Distr0hopper/Self-Driving-RC-Car/README.md

# Self-Driving-RC-Car
A RC-Car that automatically can drive down a building and detect where a misplaced barrel is, report its position, dock a magnet to it and return with it, pulling it to start in exactly one minute.

## Project Structure

- `/safety-system` - ESP32 wireless safety switch (Huzzah remote + Dev C onboard)
- `/motor-control` - ESP32 motor controller code (PlatformIO project)
- `/ros2` - ROS2 packages (will be added) 
- `/docs` - Documentation (will be added)
