Distr0hopper/Self-Driving-RC-Car/docs/hardware/motor_specs.md

# Motor Specifications

## Katana (200 RPM)
- Model: gs20205-03 25GA371
- Speed: 200 RPM @ 12V
- Encoder: 11 PPR
- Counts/Rev: 988.3
- Gear Ratio: 22.46:1 (~22.5:1)
- Wiring: A→Yellow, B→Green

### Calibration Test (1000 revolutions)
- Range: 987.82 to 988.67 counts/rev
- Average: 988.3 counts/rev

## Kimono (1000 RPM)
- Model: SKU gs20179-01 JGA25-371 DDC12V1000RPM
- Speed: 1000 RPM @ 12V
- Encoder: 11 PPR
- Counts/Rev: 204.24
- Gear Ratio: 4.64
- Wiring: A→Yellow, B→Green

### Calibration Test (1000 revolutions)
- Range: 204.09 to 204.24 counts/rev
- Average: 204.19 counts/rev

## Not-Used // Backup (100 RPM)
- Model: gs20205-05 25GA371
- Speed: 100 RPM @ 12V
- Encoder: 11 PPR
- Counts/Rev: 2174.92
- Gear Ratio: 49.43:1 (~49.5:1)
- Wiring: A→Yellow, B→Green

### Calibration Test (1000 revolutions)
- Range: 2173.02 to 2175.16 counts/rev
- Average: 2174.92 counts/rev
