Distr0hopper/Self-Driving-RC-Car/docs/schematics/katana_schematics.png

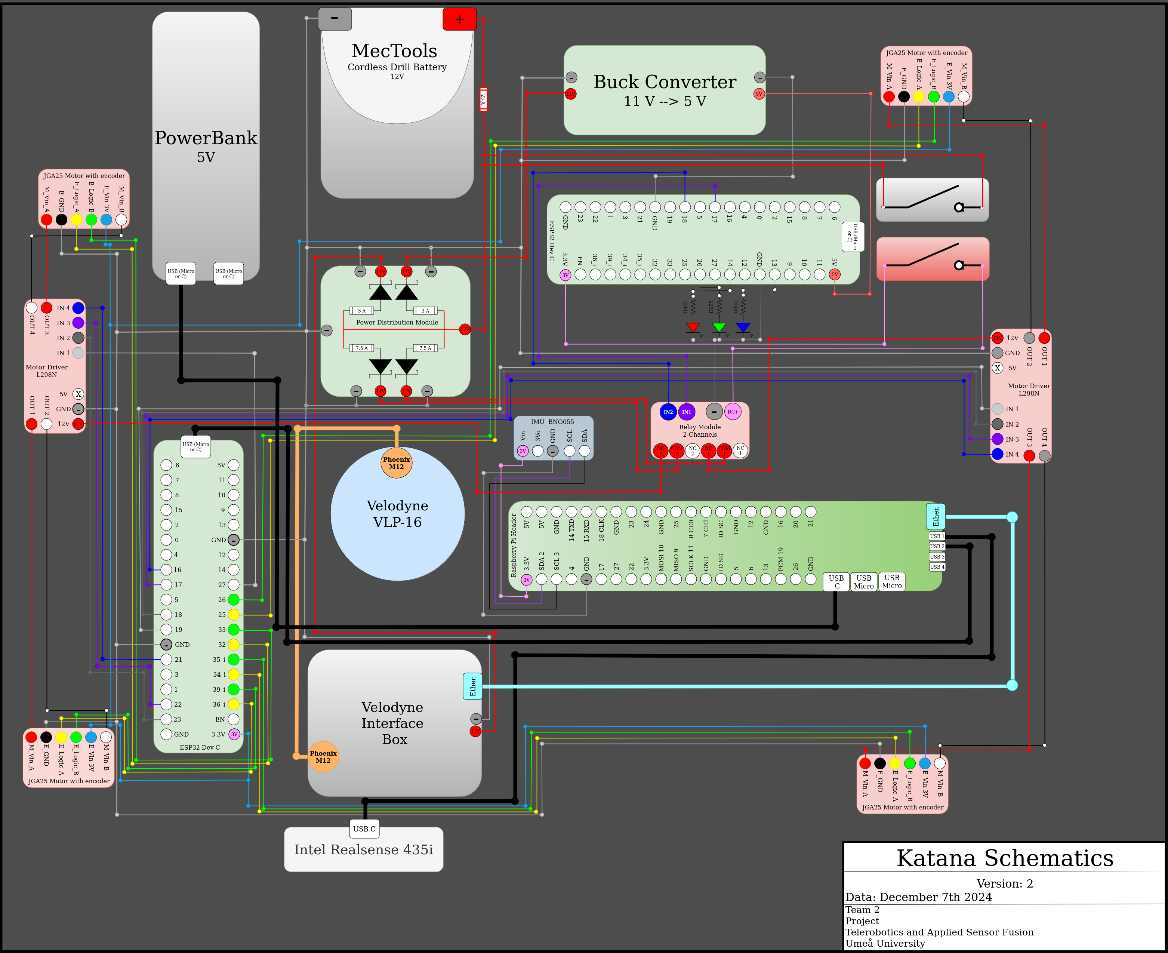
docs/schematics/katana_schematics.png
