Distr0hopper/Self-Driving-RC-Car/MotorControlCalibration/step_response_results/jga25_371_12v0_20241208_044220.csv

PWM | Velocity (m/s) | Speed (RPS) | Speed (RPM)
255 | 4.845462390880768 | 6.321141730119245 | 379.2685038071547
