Distr0hopper/Self-Driving-RC-Car/MotorControlCalibration/step_response_results/jga25_371_12v0_20241208_044220.png

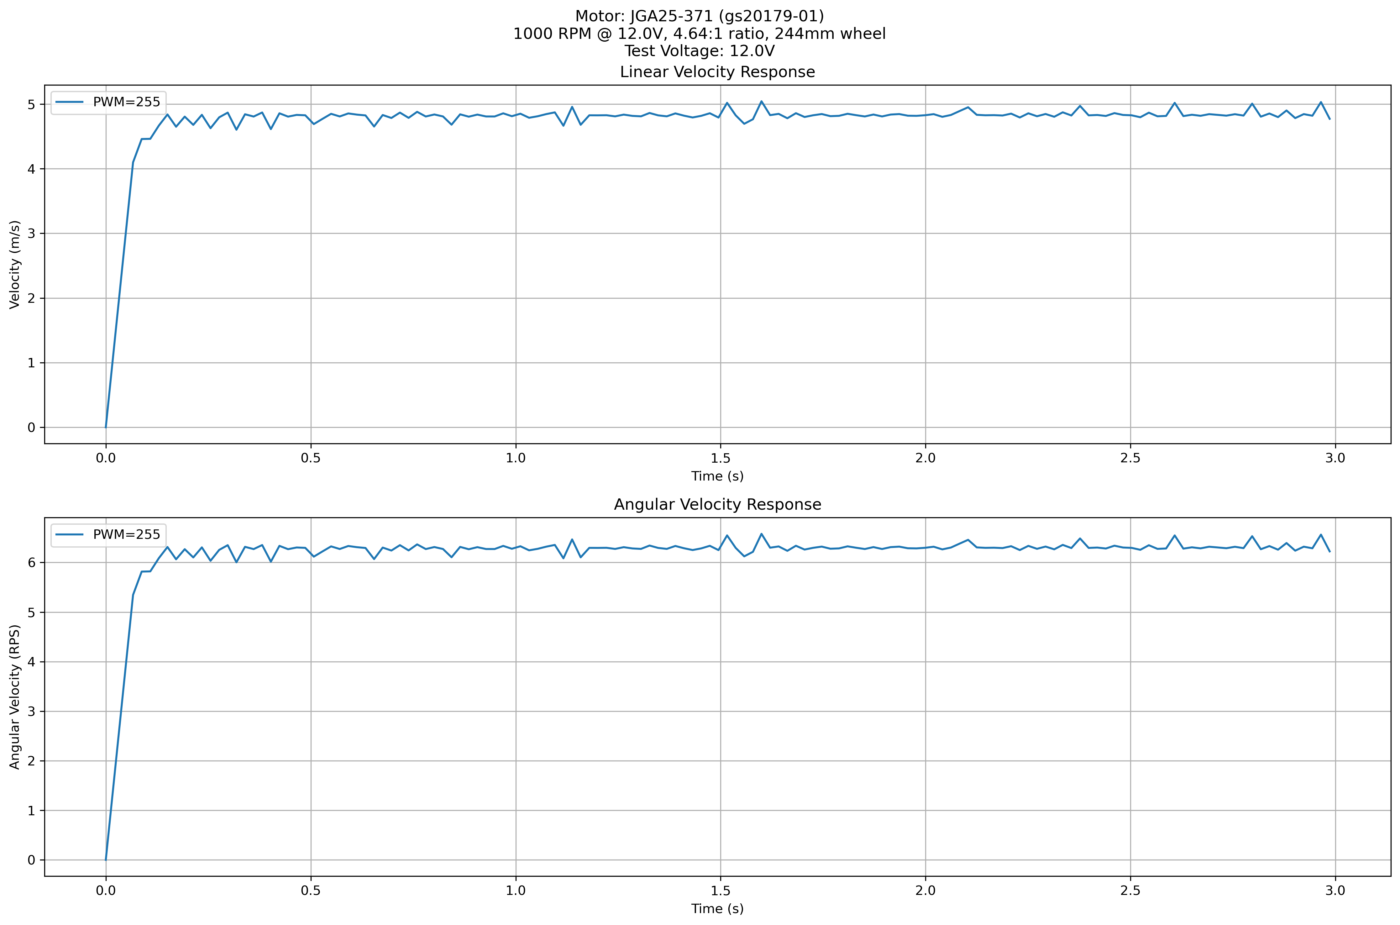
MotorControlCalibration/step_response_results/jga25_371_12v0_20241208_044220.png
