Distr0hopper/Self-Driving-RC-Car/MotorControlCalibration/step_response_test_1000RPM_noload/jga25_371_12v0_20241208_035431.png

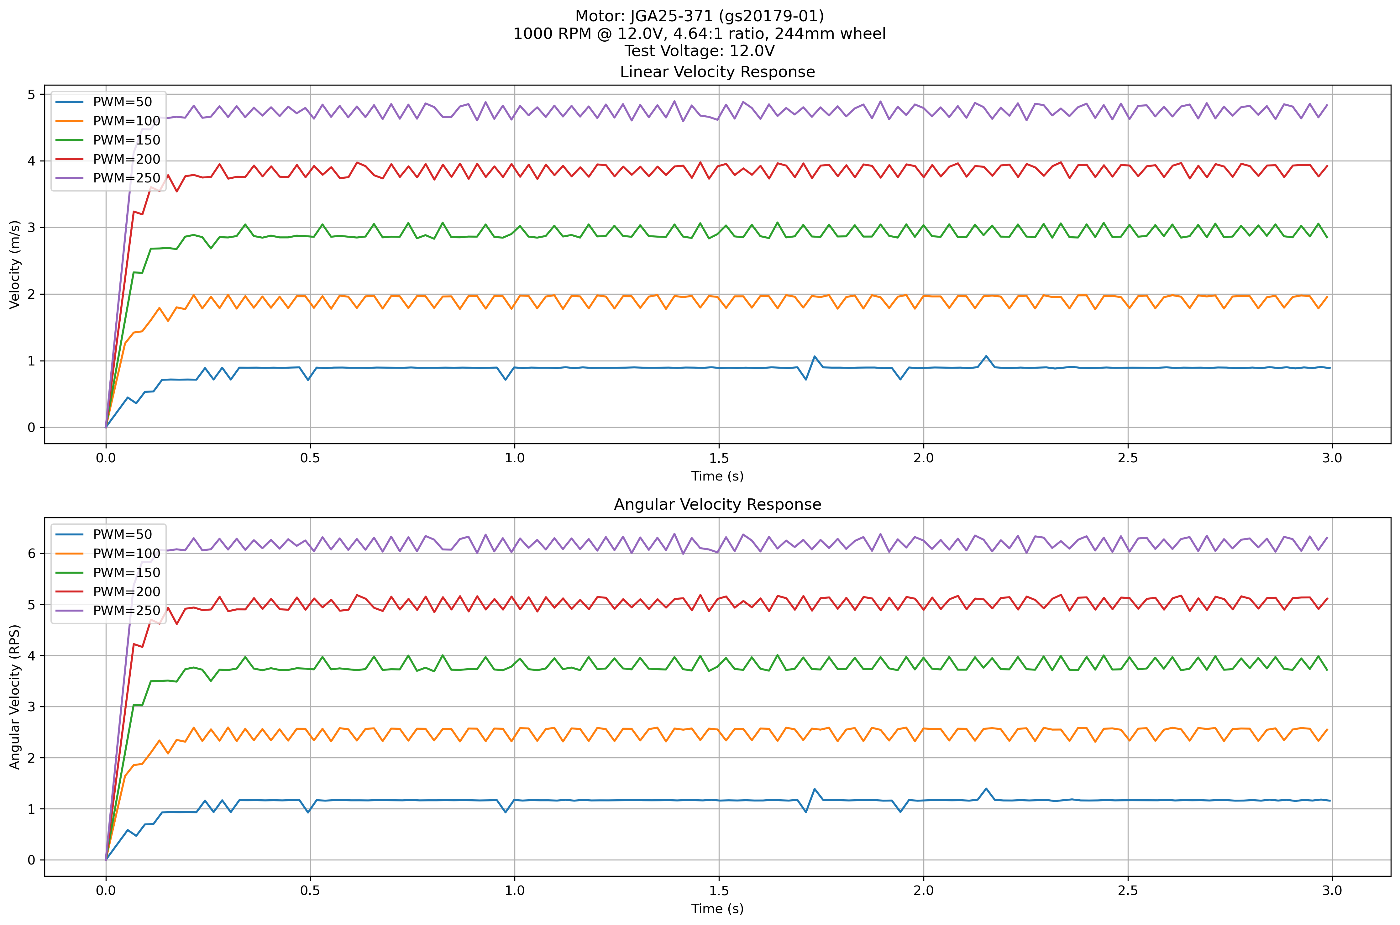
MotorControlCalibration/step_response_test_1000RPM_noload/jga25_371_12v0_20241208_035431.png
