Distr0hopper/Self-Driving-RC-Car/MotorControlCalibration/pid_test_results/pid_test_results_20241208_225130.png

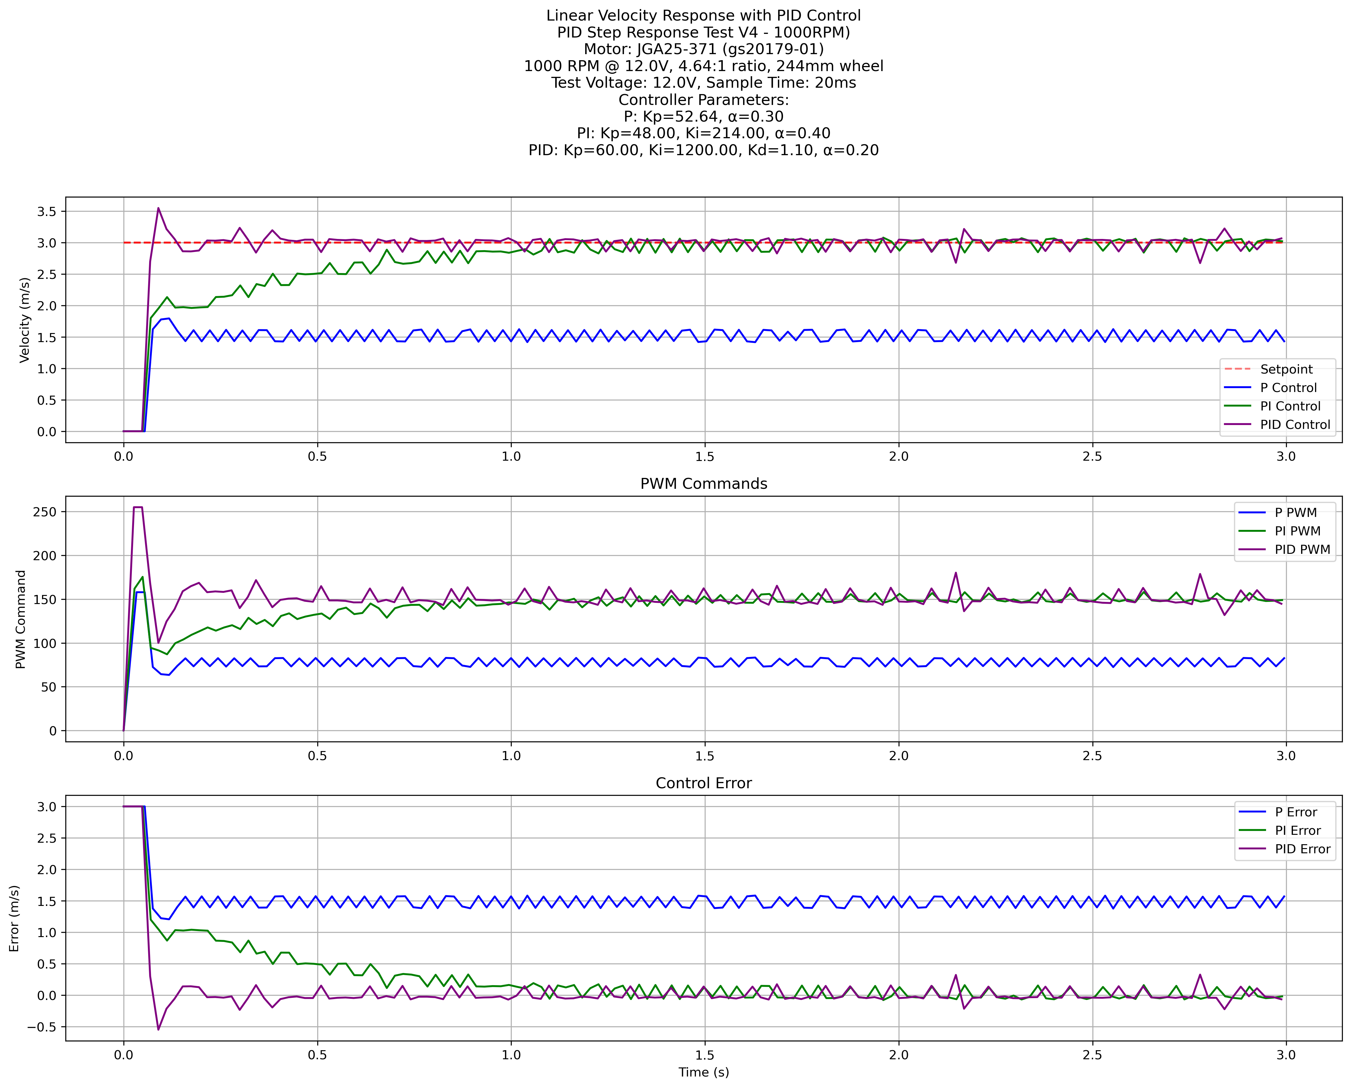
MotorControlCalibration/pid_test_results/pid_test_results_20241208_225130.png
