Distr0hopper/Self-Driving-RC-Car/MotorControlCalibration/pid_tune_results/jga25_371_12v0_20241208_042923.png

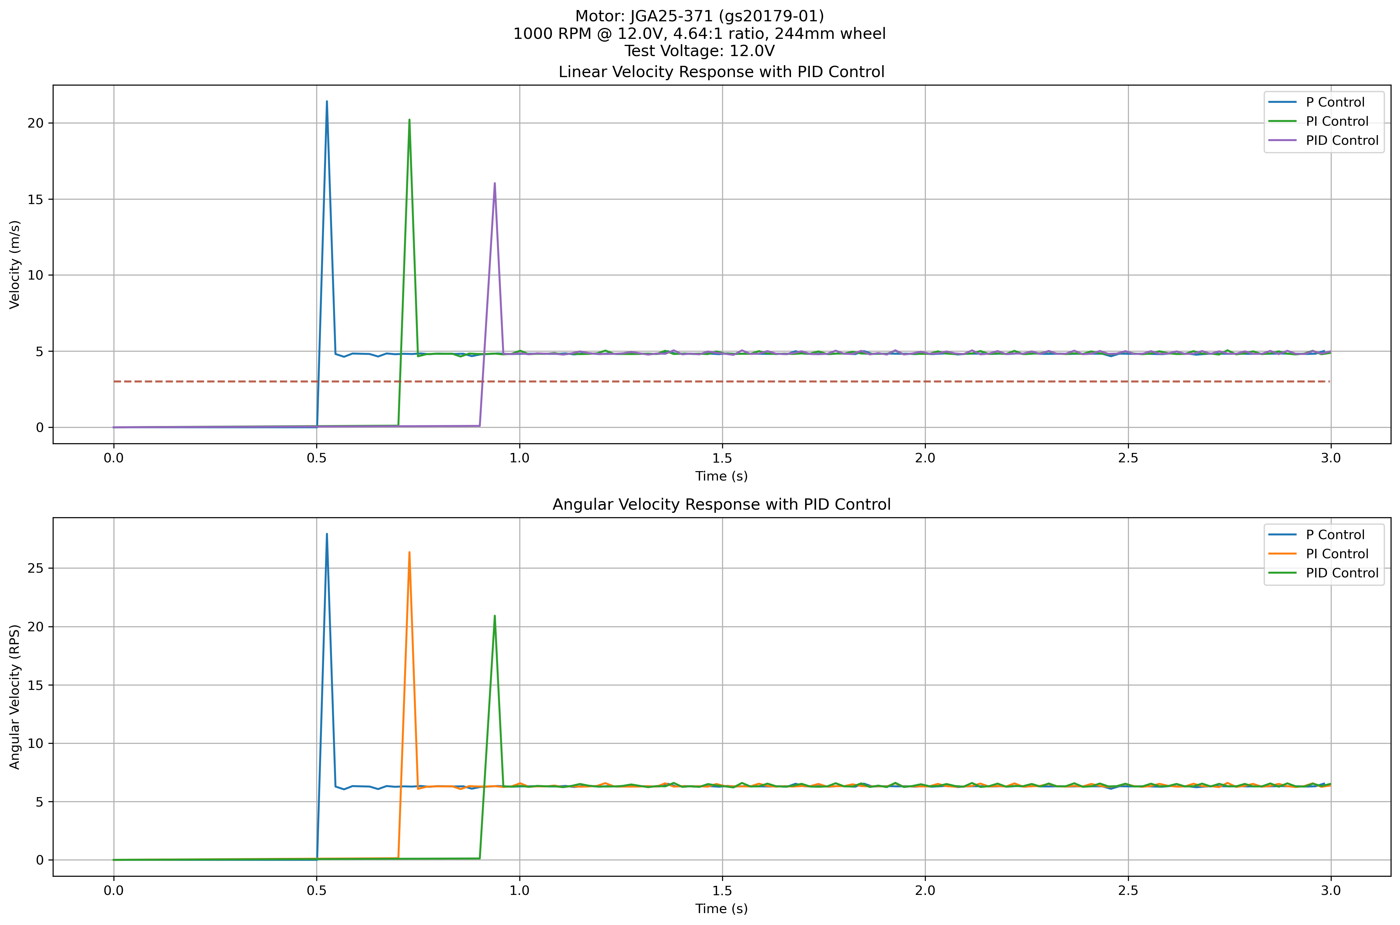
MotorControlCalibration/pid_tune_results/jga25_371_12v0_20241208_042923.png
