Distr0hopper/Self-Driving-RC-Car/MotorControlCalibration/PID_tuner_ZIegler.png

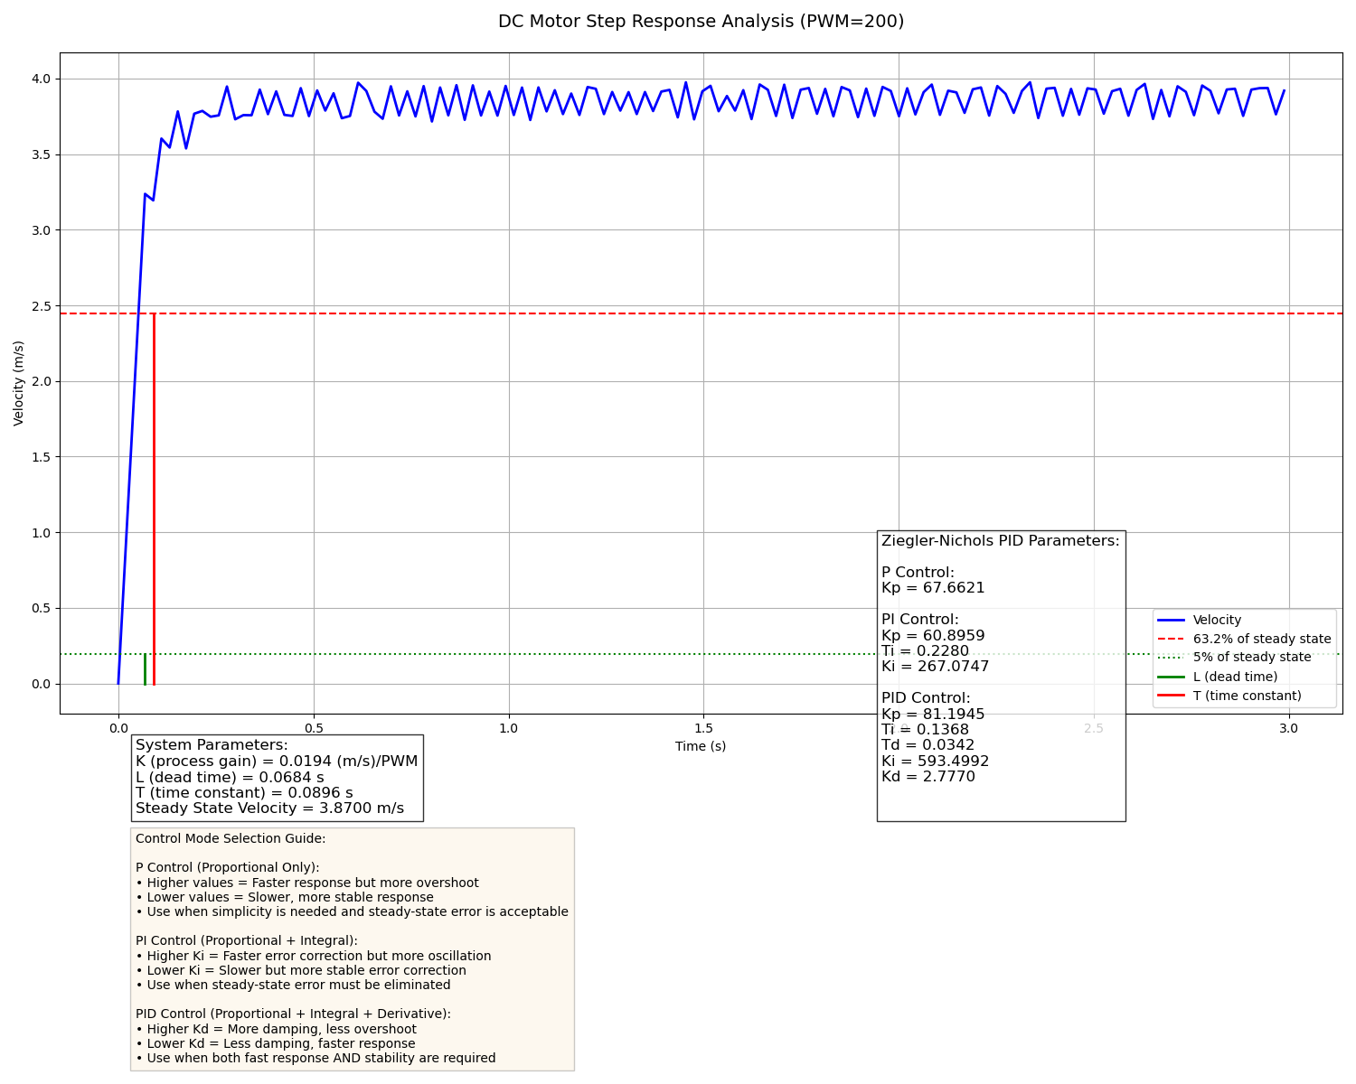
MotorControlCalibration/PID_tuner_ZIegler.png
