Distr0hopper/Self-Driving-RC-Car/(commit log)

2024-11-19 Safety Switch
    Stand-alone safety switch subsystem using two ESP-32s.
2024-11-19 motor_control_esp32
    Motor control using an esp32, it communicates with the Rasberry Pi 4 through serial.
    The code does two things:
    1. It recieves control commands from Rasberry pi and sends them to the Motor Encoders.
    2. It counts the Encoder pulses using interrupts, as well as publishes the counts through serial to the Pi 4.
2024-12-07 Add motor specifications and calibration data
2024-12-07 Add Katana UGV schematics diagram
2024-12-08 Add motor calibration: encoder calibration, step response, PID tuning scripts and test results
    [jga25_371_12v0_20241208_035431.csv, jga25_371_12v0_20241208_042923.csv, jga25_371_12v0_20241208_044220.csv, pid_test_results_20241208_224815.json, pid_test_results_20241208_224845.json, pid_test_results_20241208_224922.json, pid_test_results_20241208_225011.json, pid_test_results_20241208_225034.json]
2024-12-08 Update MotorControlCalibration: reorganize files and add latest test
    [pid_test_results_20241208_233319.json, pid_test_summary_20241208_233319.csv]
